LiveLeds/AstraBeamLED/README.md

# AstraBeamLED

[GitHub IO Page](https://liveleds.github.io/AstraBeamLED)
