LiveLeds/AstraBeamLED/AstraBeamLEDPCB/AstraBeamLED.kicad_pcb

## KiCad design AstraBeamLEDPCB/AstraBeamLED.kicad_pcb (2025-05-03)

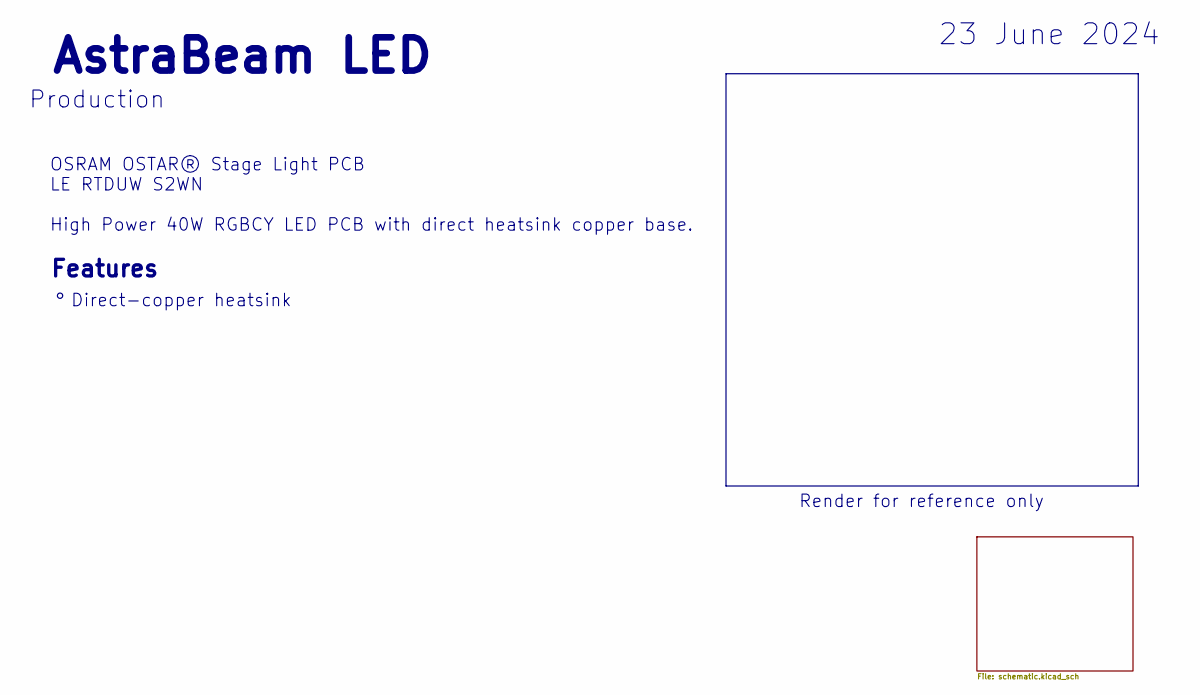
[picture p3: schematic AstraBeamLED.kicad_sch, Cover]

Notes on the sheet:
Features
OSRAM OSTAR® Stage Light PCB LE RTDUW S2WN High Power 40W RGBCY LED PCB with direct heatsink copper base.
AstraBeam LED
Direct-copper heatsink
Render for reference only
Production
23 June 2024

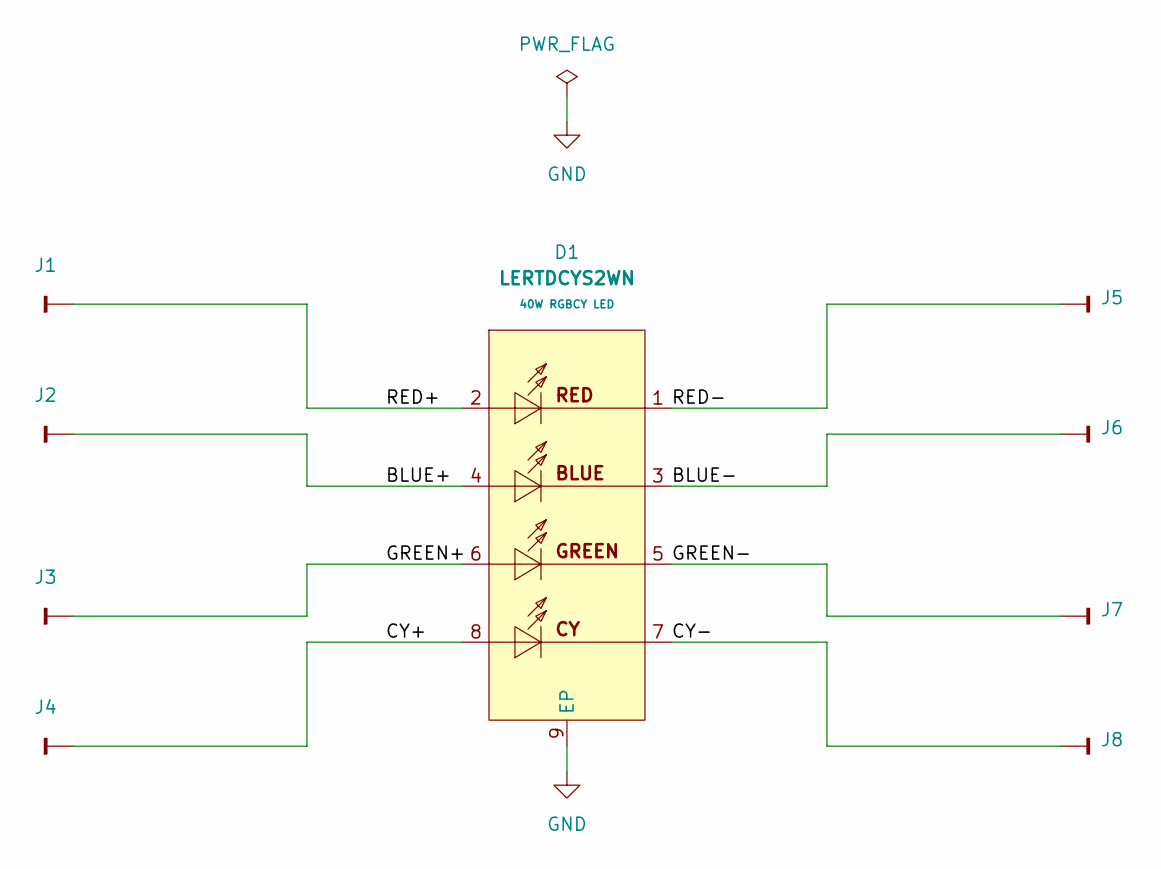
[picture p4: schematic schematic.kicad_sch, AstraBeam LED]

Parts:
D1: LERTDCYS2WN; LED_LERTDCYS2WN; MPN LERTDCYS2WN-KBLA-1+MANA-P+AXAZ-3+LBMB-YS; LCSC Part C2899869
J1, J2, J3, J4, J5, J6, J7, J8: SolderWirePad_1x01_SMD_5x10mm

Connections:
/Schematic/BLUE+: D1.4, J2.1
/Schematic/BLUE-: D1.3, J6.1
/Schematic/CY+: D1.8, J4.1
/Schematic/CY-: D1.7, J8.1
/Schematic/GREEN+: D1.6, J3.1
/Schematic/GREEN-: D1.5, J7.1
/Schematic/RED+: D1.2, J1.1
/Schematic/RED-: D1.1, J5.1
GND: D1.9 (EP)

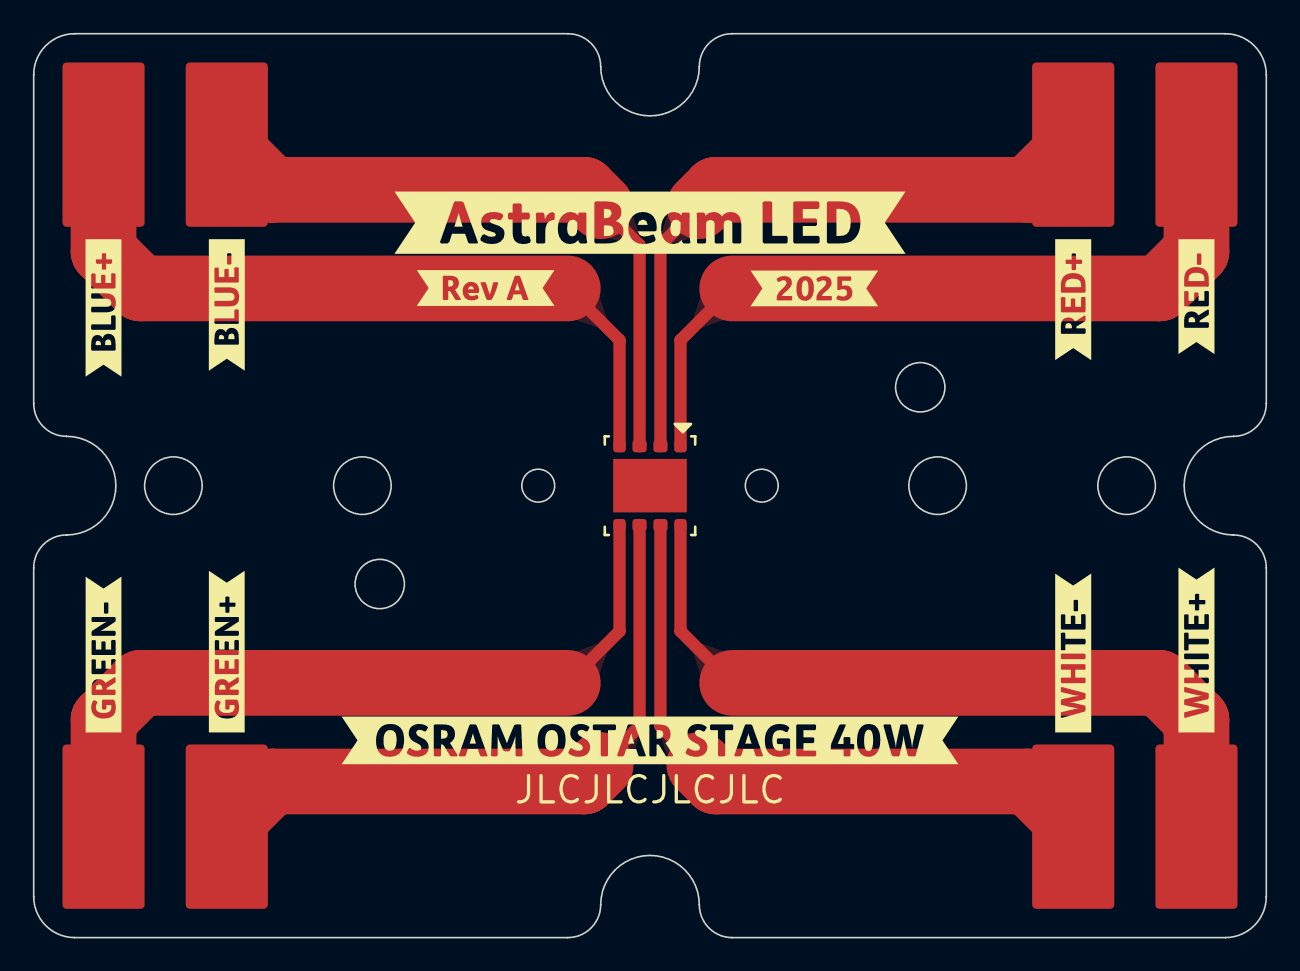
[picture p5: board AstraBeamLED.kicad_pcb from above]

Board: 2 copper layers, 75.0 x 55.0 mm, 21 parts (0 on the bottom side), 8 nets.

Other parts of the board:
kibuzzard-678EC3F2: G***; kibuzzard-678EC3F2
kibuzzard-678EC518: G***; kibuzzard-678EC518
kibuzzard-67294BDE: G***; kibuzzard-67294BDE
kibuzzard-67294BF2: G***; kibuzzard-67294BF2
kibuzzard-68162CBA: G***; kibuzzard-68162CBA
kibuzzard-68162CC4: G***; kibuzzard-68162CC4
kibuzzard-68162CCF: G***; kibuzzard-68162CCF
kibuzzard-68162CD6: G***; kibuzzard-68162CD6
kibuzzard-68162D5D: G***; kibuzzard-68162D5D
kibuzzard-68162D21: G***; kibuzzard-68162D21
kibuzzard-68162D41: G***; kibuzzard-68162D41
kibuzzard-68162D54: G***; kibuzzard-68162D54
