LiveLeds/AstraBeamLED/(commit log)

2024-11-03 Fix pcb print
2024-11-03 Added ti connectors
    [AstraBeamLED.kicad_pcb, schematic.kicad_sch]
2024-11-04 Redesigned pcb for smaller size
    [AstraBeamLED.kicad_pcb, schematic.kicad_sch]
2024-11-04 Updated step path
    [AstraBeamLED.kicad_pcb]
2024-11-04 Improve render
    [AstraBeamLED.kicad_pcb]
2024-11-05 Update for render
    [AstraBeamLED.kicad_pcb]
2024-11-05 holes 29mm instead of 30mm
    [AstraBeamLED.kicad_pcb]
2024-11-05 tweak heatsink
    [AstraBeamLED.kicad_pcb, AstraBeamLED.step]
2024-11-05 Save updates
    [AstraBeamLED.kicad_pcb]
2024-11-08 LED step is messed up
    [AstraBeamLED.kicad_pcb]
2025-01-20 fix font
    [AstraBeamLED.kicad_pcb]
2025-01-20 Add 40W
    [AstraBeamLED.kicad_pcb]
2025-01-23 Tweak mounting holes
    [AstraBeamLED.kicad_pcb]
2025-02-07 Updated layout
    [AstraBeamLED.kicad_pcb, schematic.kicad_sch]
2025-02-08 Extra tweaks to copper
    [AstraBeamLED.kicad_pcb]
2025-02-08 Bring back tear drops
    [AstraBeamLED.kicad_pcb]
2025-04-01 Updated fcu copper heat sink
    [AstraBeamLED.kicad_pcb]
2025-04-04 removed mark from direct heatsink layer
    [AstraBeamLED.kicad_pcb]
2025-04-07 Cleanup copper for production
    [AstraBeamLED.kicad_pcb]
2025-05-02 Fix reversed pins
    [AstraBeamLED.kicad_pcb]
2025-05-03 Updated labels, description
    [AstraBeamLED.kicad_pcb, AstraBeamLED.kicad_sch, schematic.kicad_sch]
2025-05-03 Update finish
    [AstraBeamLED.kicad_pcb]
2025-05-03 Updated datasheet render
    [AstraBeamLED.kicad_sch]
